markwu2001/lethal-company-flashlight/Test Images/03-28-24/BuckBoost VIN 2.5V VOUT 5us timescale.jpeg

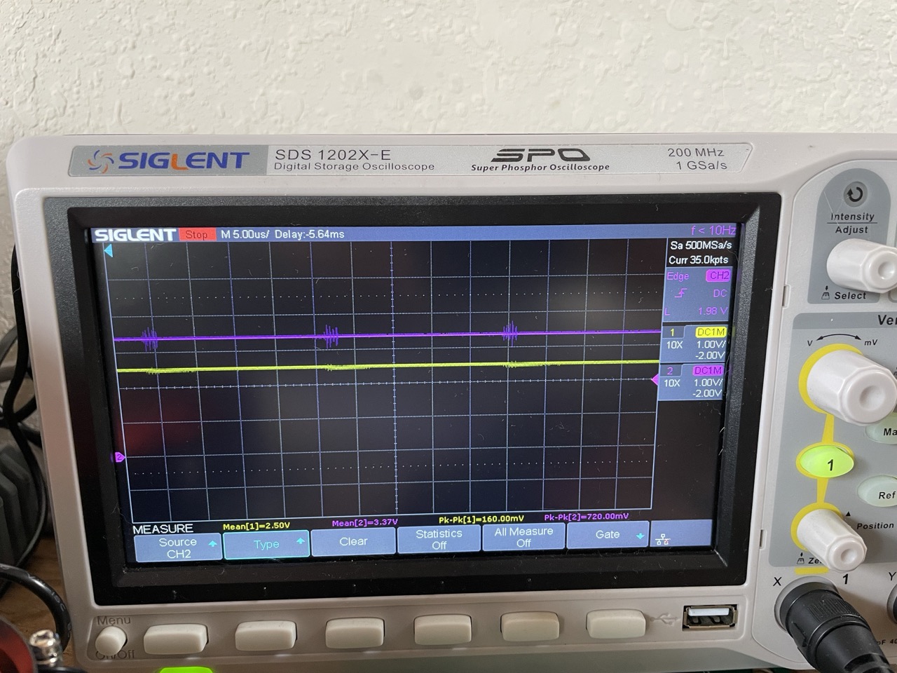
Test Images/03-28-24/BuckBoost VIN 2.5V VOUT 5us timescale.jpeg
