markwu2001/lethal-company-flashlight/README.md

# lethal-company-flashlight
Lethal Company Flashlight V1 hardware project

## View the PCB design in your browser: 

# [Power Board V1](https://flux.ai/markwuflux/lethal-company-pro-flashlight-power-board-v1) 

# [Button Board V1](https://flux.ai/markwuflux/lethal-company-pro-flashlight-button-board)
