markwu2001/lethal-company-flashlight/Test Images/03-29-24/03-29-24-CC_SMPS_Testing.rtfd/TXT.rtf

Test 1: Load set to 1.4 Ohms, Code is setting TPS63020DSJR converter Enable high.

¬

Result: Output voltage rises above 6V. This corresponds to over 4.2A! Then in 220ms, the output shuts down.
¬
Shutdown transient took roughly 2.5ms. Corresponds to the output capacitance and the resistance.
¬
Here is the same experiment with a 1Ohm load performed while measuring the input voltage on the VBATT input node.

¬¬

Test 2: Then connected the CREE LED to the output which shows a similar result. Except the device shuts down in 750us in this capture. The LED appears to flash very bright and then shut off.
¬

Zooming into the operation point gives us a voltage of 3.28V, which explains the brief flash.
¬
After it shuts down, the voltage slowly decreases through the LED’s parasitic resistance. Here we see the voltage at 2.5V, below the forward voltage of the LED.
¬

The following description explains the captures above: Test Results with 3V-3.7V forward Voltage LED:
From a human perspective, the LED flashes bright for a small fraction of a second after turning on a 4V power supply.
1.8V output SS -> 140us transient to 3.3V output for 700us -> 40us fall transient to 2.49V

After looking at the data sheet, we see the following description of the short circuit protection. This is consistent with the behavior we’re seeing.
¬

The same test is performed while measuring the input VBATT voltage node
¬¬
We can see that the buck boost is in buck operation here.

And we can get a closer look at the signal. It appears the device shuts down in a similar 800us timeframe.
¬¬

Upon probing the VFB pin, I discovered that the current sense amplifier is not producing the desired output voltage.
¬
Let us zoom in.

¬¬<-Setup
We’re looking at 42mV for a 6.71V input. I have a 1.4Ohm load. 6.7V should be like 4.8A. 2.5A should correspond to 1.2V so i shouldnt be seeing 40mV on the feedback pin. *The current sense and amp circuit has 2.5A correspond to 1.2V
And indeed, after looking at the data sheet, this amplifier is designed to operate with a 2.5V common mode voltage….
¬

This means all hope is not necessarily lost. We may be able to remove this part and put a bigger resistor but will have to deal with it getting kind of hot.
