markwu2001/lethal-company-flashlight/Test Images/03-28-24/Board Thickness.jpeg

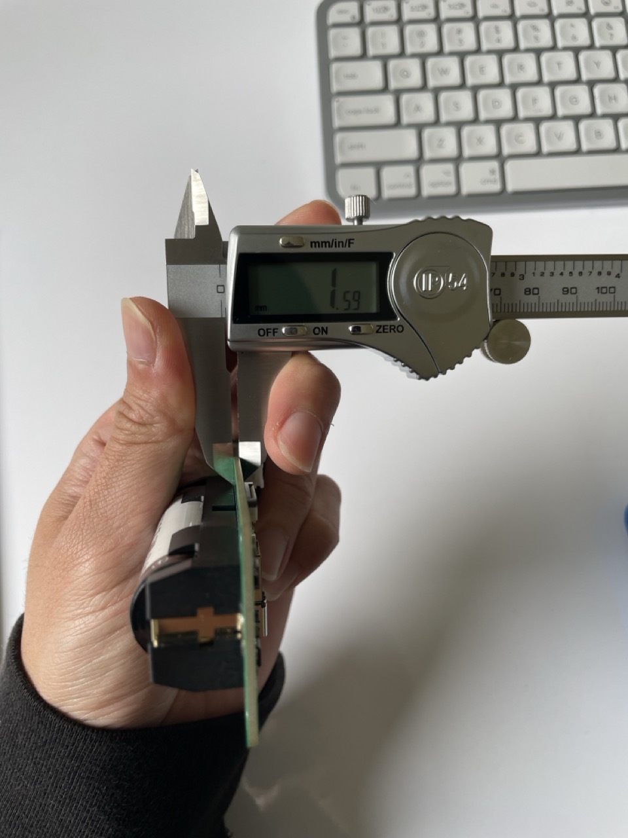
Test Images/03-28-24/Board Thickness.jpeg
