markwu2001/lethal-company-flashlight/Test Images/03-28-24/Broke off GND Test Grabber.jpeg

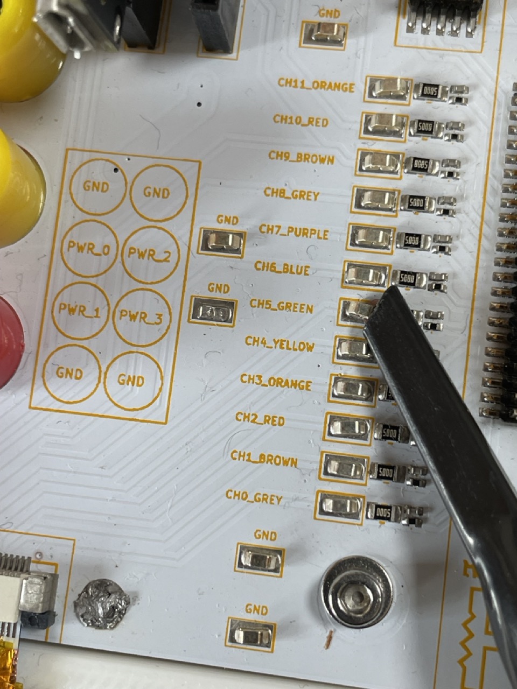
Test Images/03-28-24/Broke off GND Test Grabber.jpeg
