markwu2001/lethal-company-flashlight/Test Images/03-28-24/BuckBoost VIN 4V VOUT.jpeg

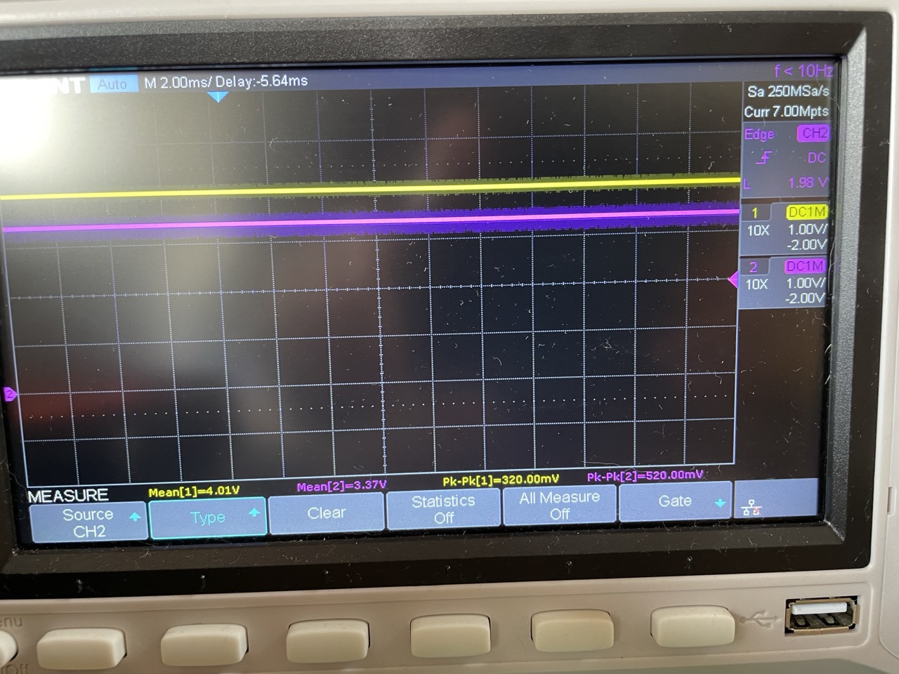
Test Images/03-28-24/BuckBoost VIN 4V VOUT.jpeg
