markwu2001/lethal-company-flashlight/Test Images/03-28-24/BuckBoost VIN and VOUT Cold Start.jpeg

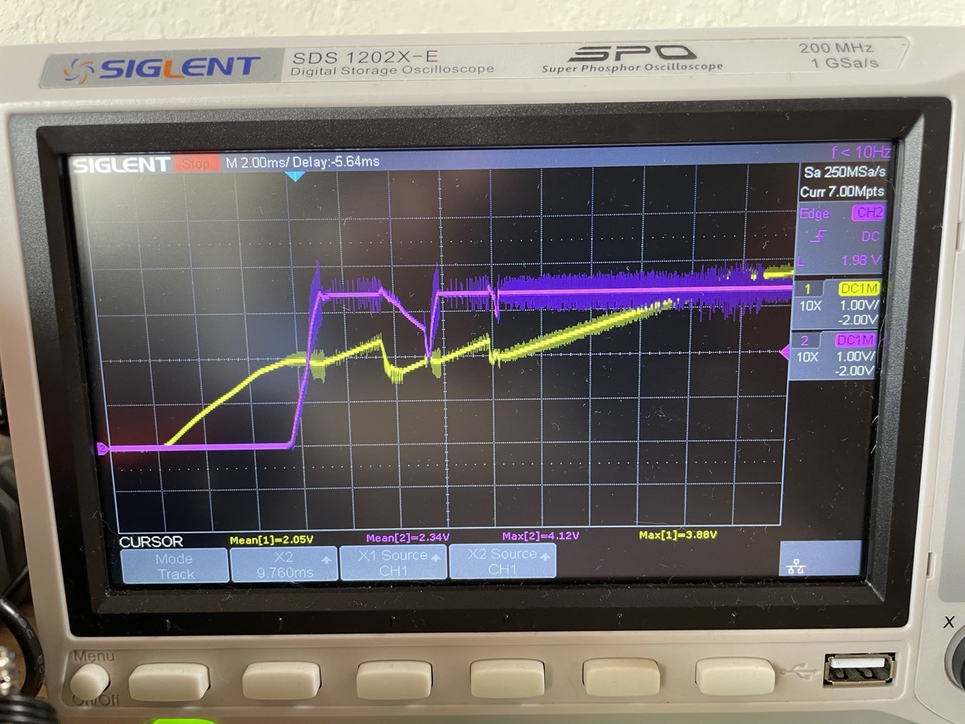
Test Images/03-28-24/BuckBoost VIN and VOUT Cold Start.jpeg
