markwu2001/lethal-company-flashlight/Test Images/03-28-24/BuckBoost VOUT (P) and PG (Y) 4V input.jpeg

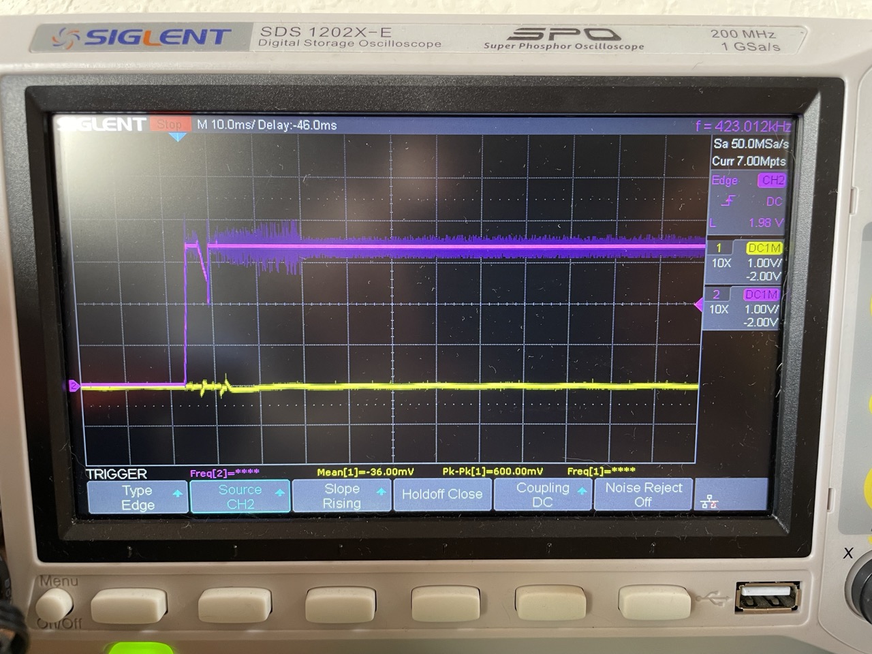
Test Images/03-28-24/BuckBoost VOUT (P) and PG (Y) 4V input.jpeg
