markwu2001/lethal-company-flashlight/Test Images/03-28-24/Probing 5015.jpeg

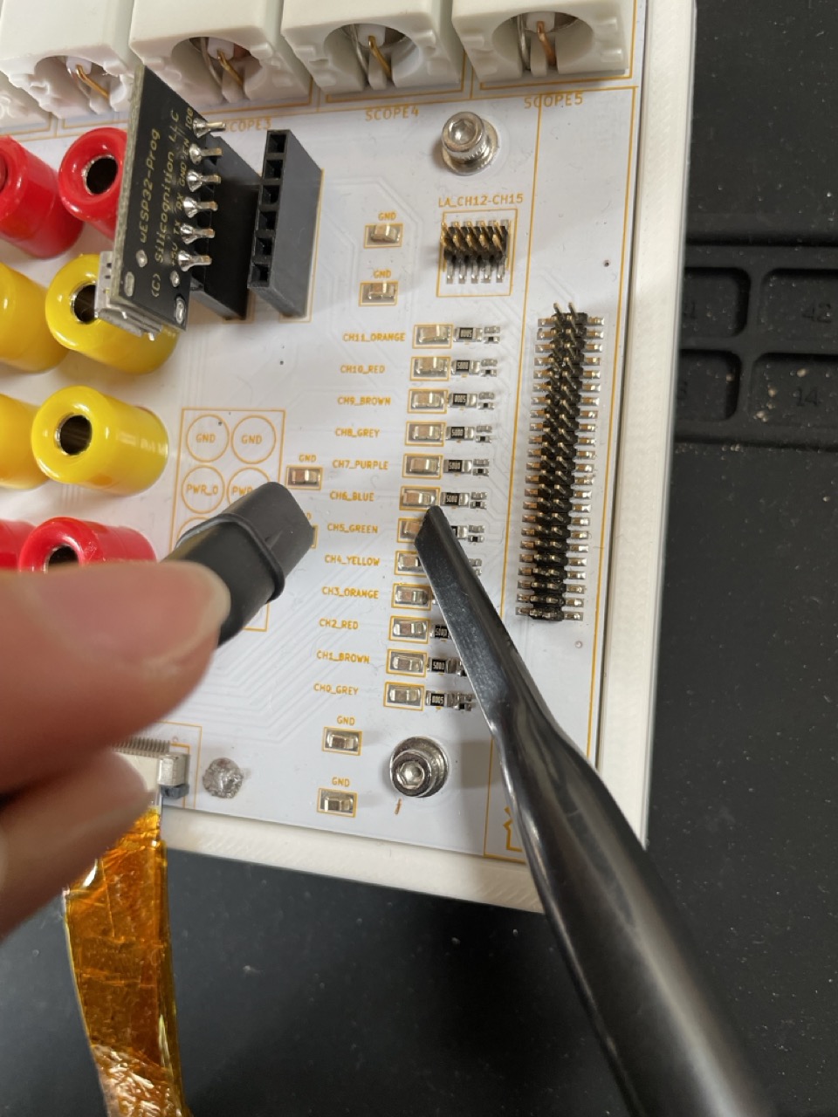
Test Images/03-28-24/Probing 5015.jpeg
