markwu2001/lethal-company-flashlight/Test Images/03-28-24/Test Setup.jpeg

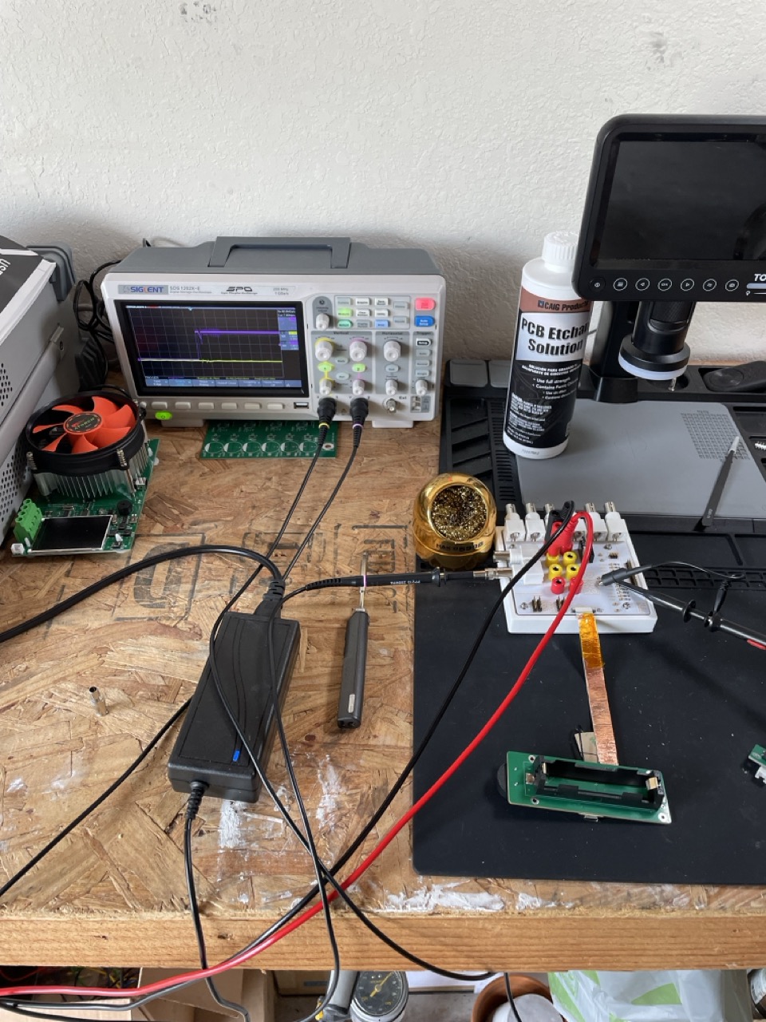
Test Images/03-28-24/Test Setup.jpeg
