markwu2001/lethal-company-flashlight/Test Images/03-29-24/03-29-24-CC_SMPS_Testing.rtfd/IMG_4997 Large.jpeg

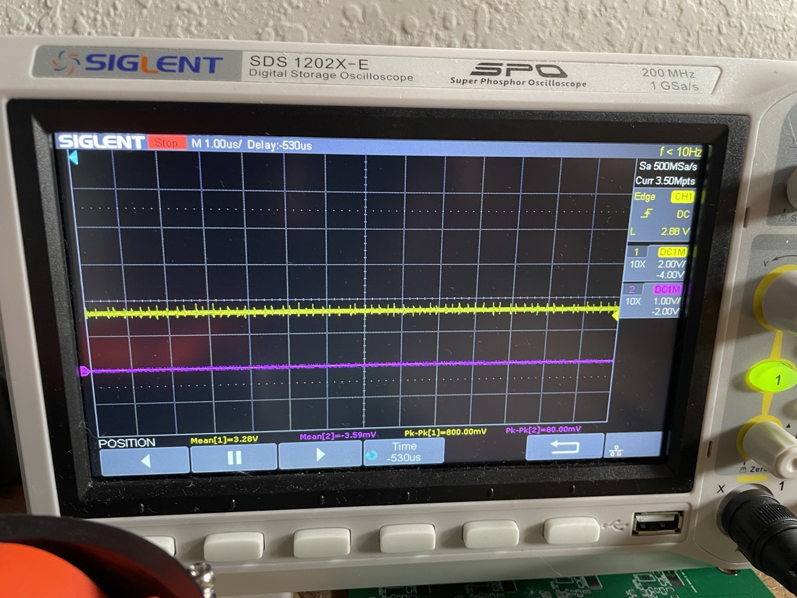
Test Images/03-29-24/03-29-24-CC_SMPS_Testing.rtfd/IMG_4997 Large.jpeg
