markwu2001/lethal-company-flashlight/Test Images/03-29-24/03-29-24-CC_SMPS_Testing.rtfd/Screenshot 2024-03-29 at 3.53.26 PM.png

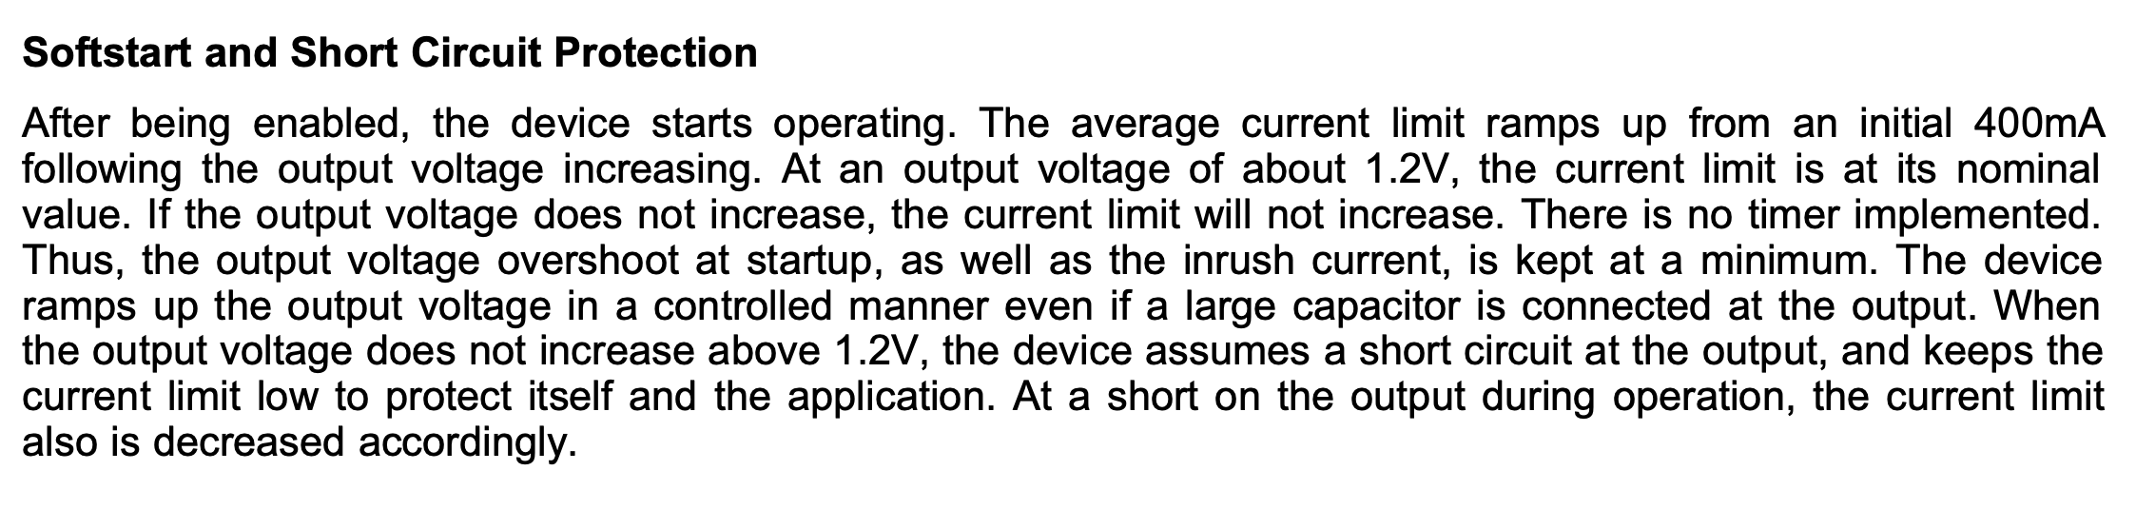
Test Images/03-29-24/03-29-24-CC_SMPS_Testing.rtfd/Screenshot 2024-03-29 at 3.53.26 PM.png
