markwu2001/lethal-company-flashlight/Test Images/03-29-24/IMG_4996 Large.jpeg

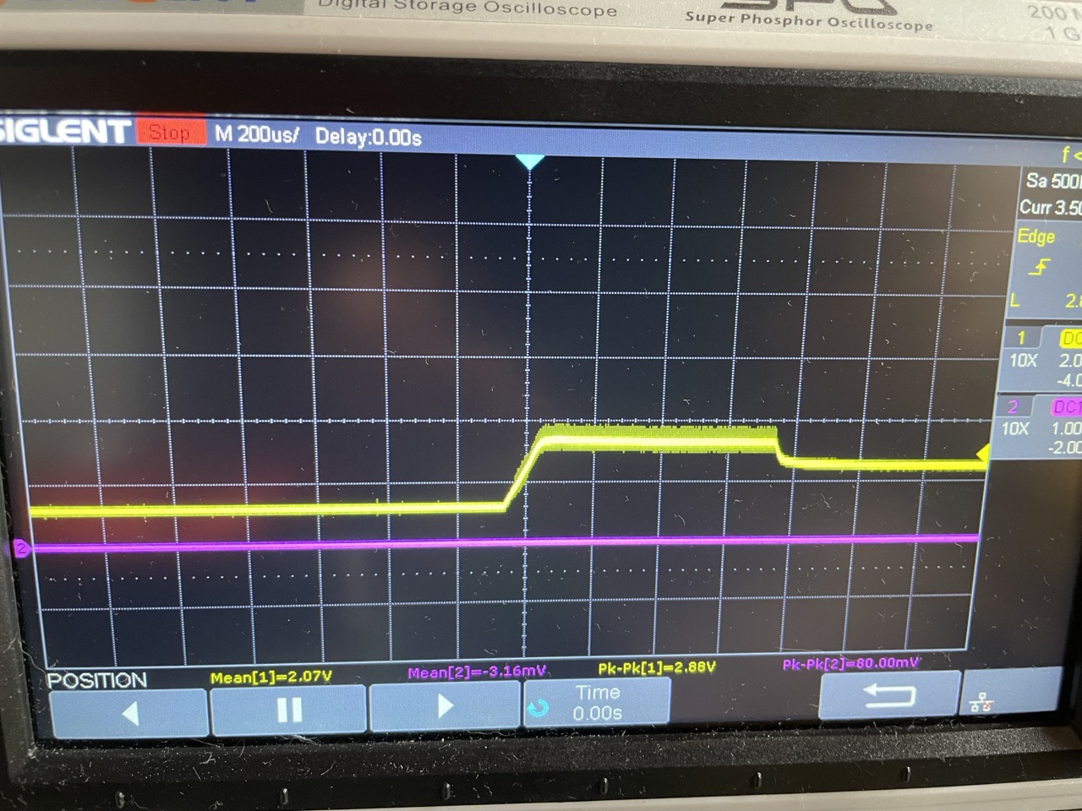
Test Images/03-29-24/IMG_4996 Large.jpeg
