markwu2001/lethal-company-flashlight/Test Images/03-29-24/Test 3/IMG_5012 Large.jpeg

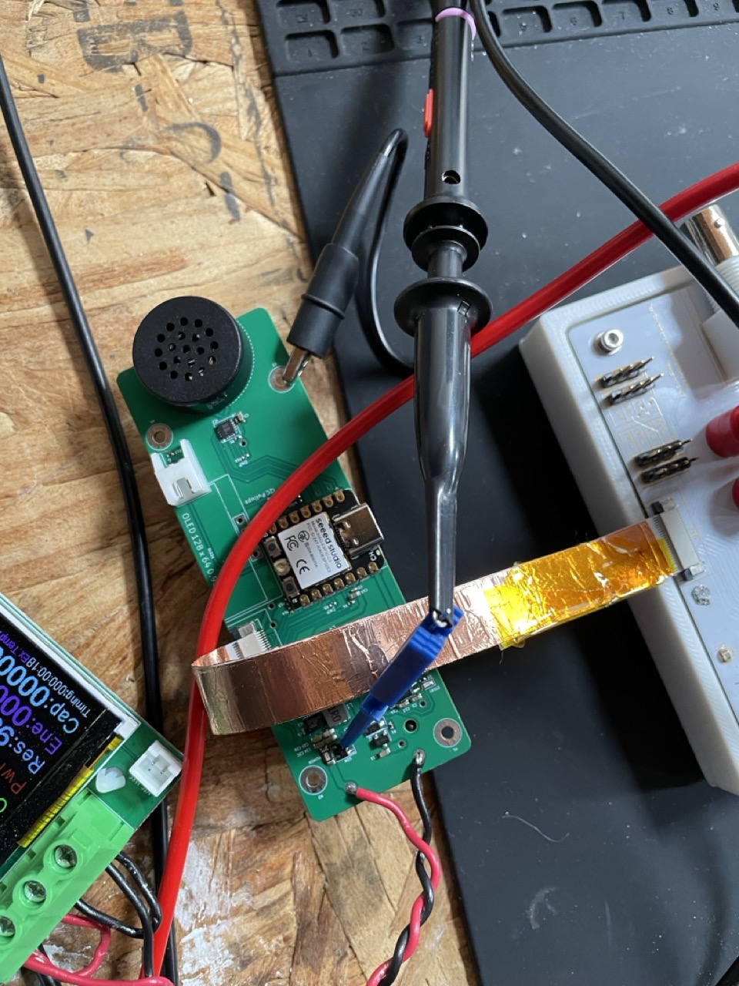
Test Images/03-29-24/Test 3/IMG_5012 Large.jpeg
