markwu2001/lethal-company-flashlight/(commit log)

2024-03-29 Added Test data from 03-29-24
    Tested the LED Driver circuit and found out that it doesn't work due to short circuit protection on the SMPS IC.
2024-03-30 added test results from testing the VFB pin
2024-03-31 passed hello world display test on display board
    added Display test code from tutorial. Tested on board with successful results.
2024-03-31 provided test code to draw lethal company battery iamge
    have not tested but compiles properly.
2024-03-31 Added Images and got code working to demo a single image
    Created 10 images from 0-100 in procreate. Replaced display driver code with example that displays a single image properly
2024-03-31 added battery charge and discharge animations
    Battery charge and discharge animations on the display board are working well. Edited ReadMe as well to include links to the hardware
